Asmyldof/SolarManager/Documentation/Pictures/Electronics Installed.JPG

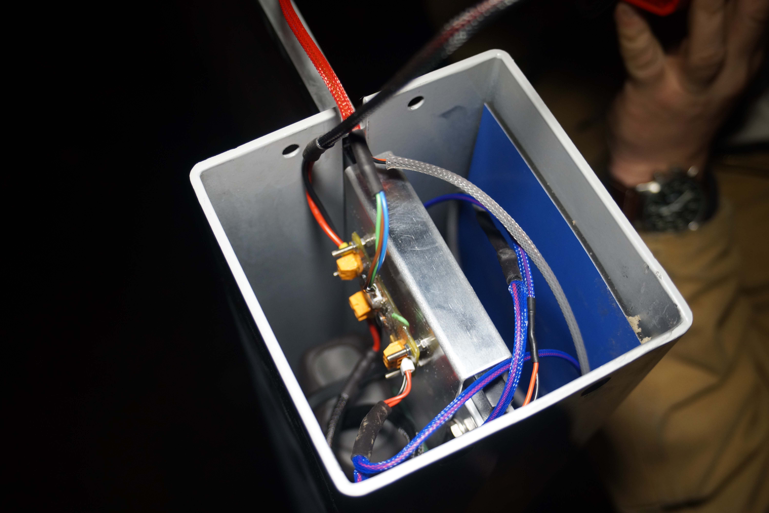
Documentation/Pictures/Electronics Installed.JPG
