Asmyldof/SolarManager/Sensor Board/IRSolarSensor - Scematic.pdf

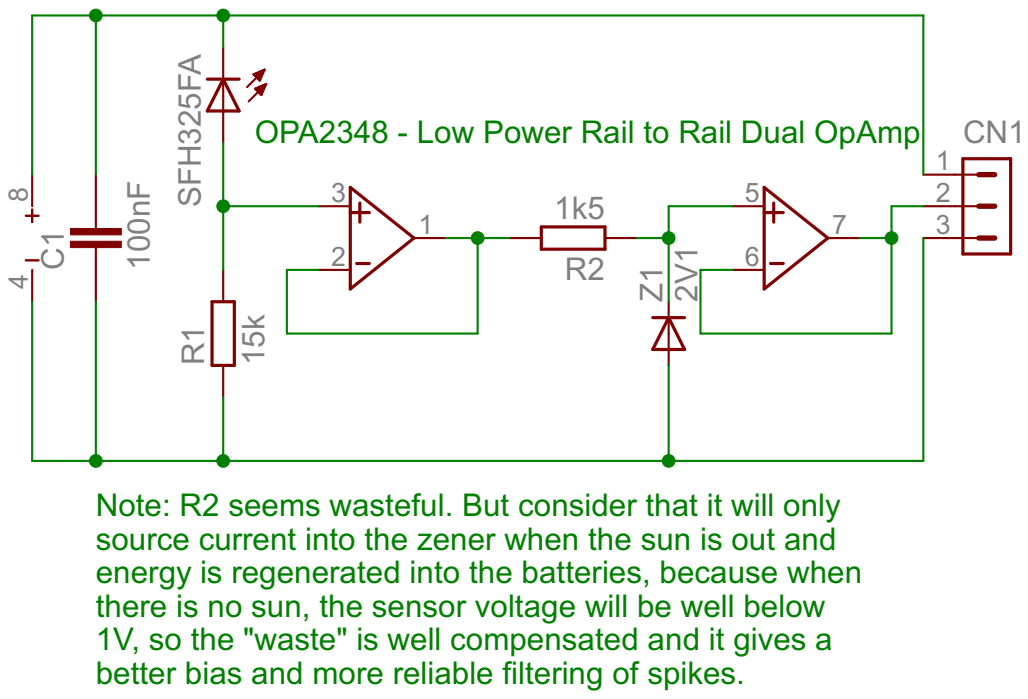
[picture p6: page 1]

1 OPA2348 - Low Power Rail to Rail Dual OpAmp

Note: R2 seems wasteful. But consider that it will only
source current into the zener when the sun is out and
energy is regenerated into the batteries, because when
there is no sun, the sensor voltage will be well below
1V, so the "waste" is well compensated and it gives a
better bias and more reliable filtering of spikes.
