Asmyldof/SolarManager/Sensor Board/IRSolarSensor - Board With Parts.pdf

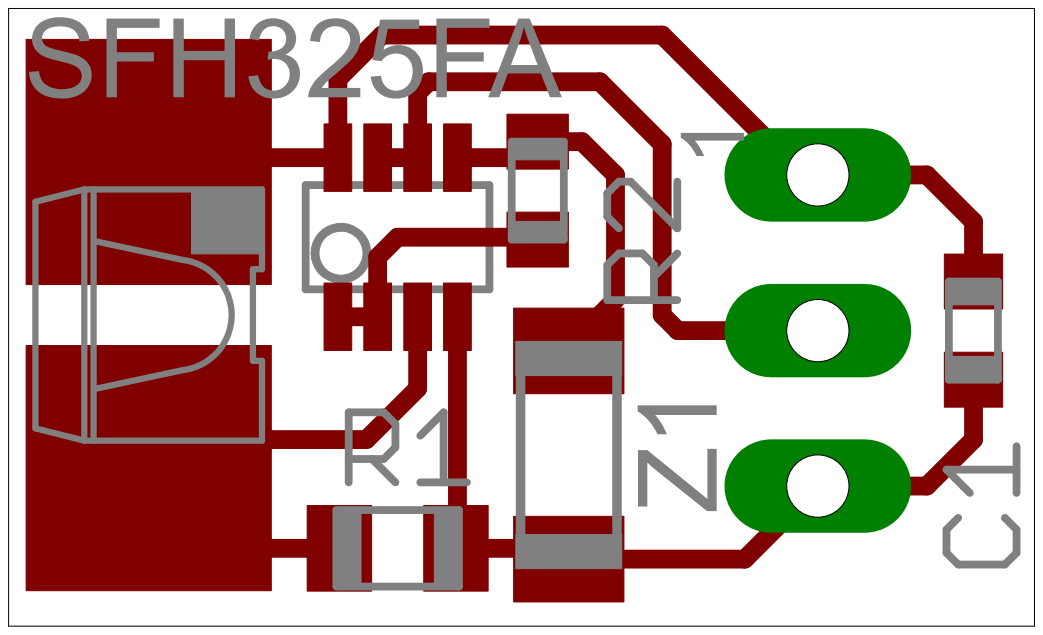
[picture p7: page 1]
