Asmyldof/SolarManager/Sensor Board/IRSolarSensor - Board TopCopper - Mirrored.pdf

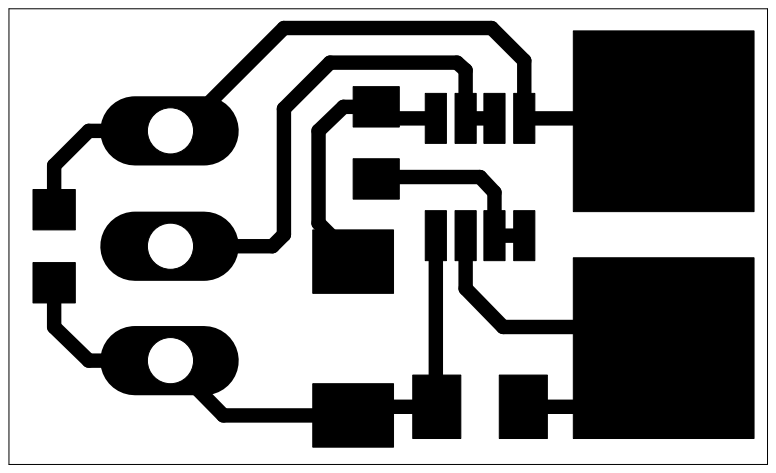
[picture p8: page 1]
