Asmyldof/SolarManager/Sensor Board/IRSolarSensor.brd

## EAGLE design Sensor Board/IRSolarSensor.brd (2014-11-10)

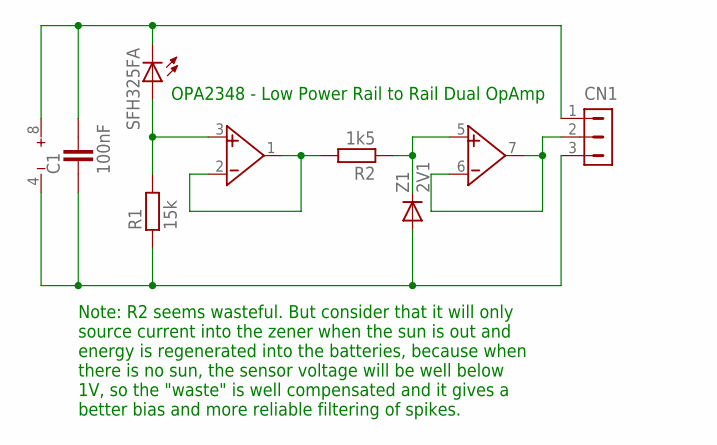
[picture p9: schematic IRSolarSensor.sch]

Parts:
C1: 100nF; CAPC1608X92N
CN1: HDR-1X3-MTA-100; MTA-100-3V
R1: 15k; RESC2012X70N
R2: 1k5; RESC1608X55N
SFH325FA: LEDSIDELED; OSRAM-SIDELED
U$1: OPA2348; DCN-R-PDSO-G8
Z1: 2V1; MINIMELF

Connections:
BUFFER: R2.2, U$1.1 (O), U$1.2 (-)
GND: C1.1, CN1.3, R1.1, U$1.4 (V-), Z1.A
unnamed: R2.1, U$1.5 (+), Z1.C
OUT: CN1.2, U$1.6 (-), U$1.7 (O)
SENSOR: R1.2, SFH325FA.A, U$1.3 (+)
VCC: C1.2, CN1.1, SFH325FA.C, U$1.8 (V+)

Notes on the sheet:
OPA2348 - Low Power Rail to Rail Dual OpAmp
Note: R2 seems wasteful. But consider that it will only source current into the zener when the sun is out and energy is regenerated into the batteries, because when there is no sun, the sensor voltage will be well below 1V, so the "waste" is well compensated and it gives a better bias and more reli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

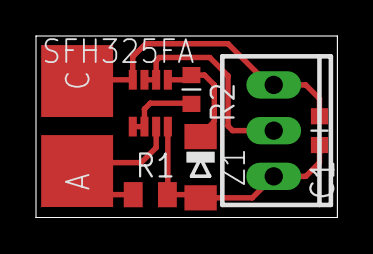
[picture p10: board IRSolarSensor.brd from above]

Board: 2 copper layers, 16.7 x 10.1 mm, 7 parts (0 on the bottom side), 6 nets.
