Asmyldof/SolarManager/(commit log)

2014-11-10 Forgot to add the ticks recalculation when entering night-mode. Fixed.
    [SolarCounter-Tiny10.c]
2014-11-10 Added Sensor Board design files
    [IRSolarSensor.brd, IRSolarSensor.sch]
2014-11-10 Added minimum daylength to prevent light effects continuously retriggering.
    [SolarCounter-Tiny10.c]
2014-11-10 Few small changes and possibly fixed the night install. Bed time now (first in 36hours).
    [SolarCounter-Tiny10.c]
2014-11-12 Added note in the description of sleep mode about PWM and power down. Also new Preprocessor TODO.
2014-12-18 Added: - Dimming settings after two independant intervals; - Resetting of DayStreak only after a certain amount of night-activity
    [SolarConfig.h, SolarCounter-Tiny10.c, SolarCounter.h]
2014-12-19 Added a calibration project, to calibrate the prescaling to the actual WDC frequency. Started debugging the new day/night system.
2014-12-19 Added brackets to all formulaic defines, in hopes to fix some operational bugs that may be caused by recursive defines.
    [SolarConfig.h, SolarCounter-Tiny10.c, SolarCounter.h]
2014-12-19 Reverted all configurations to "public defaults"
    [SolarConfig.h]
