Asmyldof/SolarManager/(notices)

Notices in the files:
parts and their libraries:
con-hdrs40: Copyright (C) 2004, Bob Starr (bobstarr@mindspring.com)
